andrea-cirillo/stm32_dali_led_driver/Docs/Schematics/Table_RvsQx.pdf

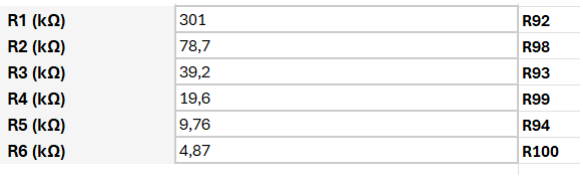
[picture p1: figure]
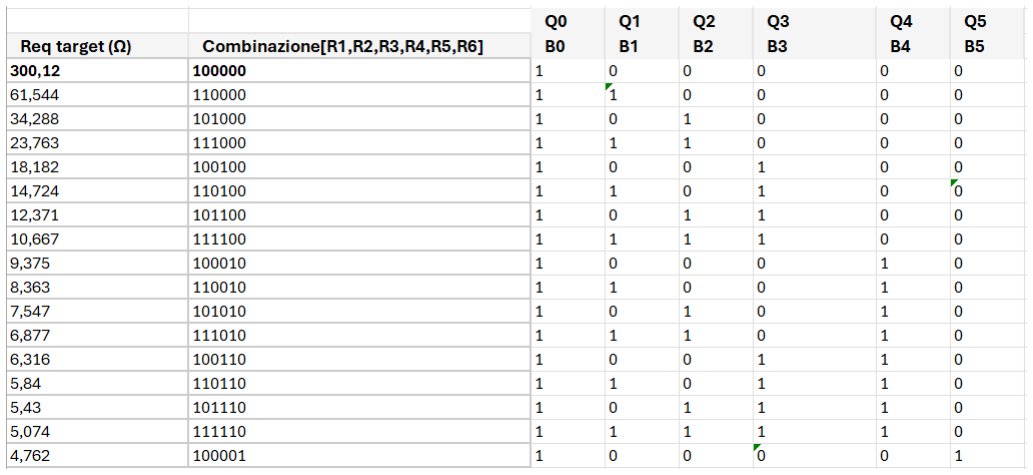
[picture p2: figure]
