andrea-cirillo/stm32_dali_led_driver/Docs/Schematics/stm32f030f4_dali_sch.pdf

## Current limitation selection

Current limitation selection | STCP SHCP CurrentLimit_DS | CS_out

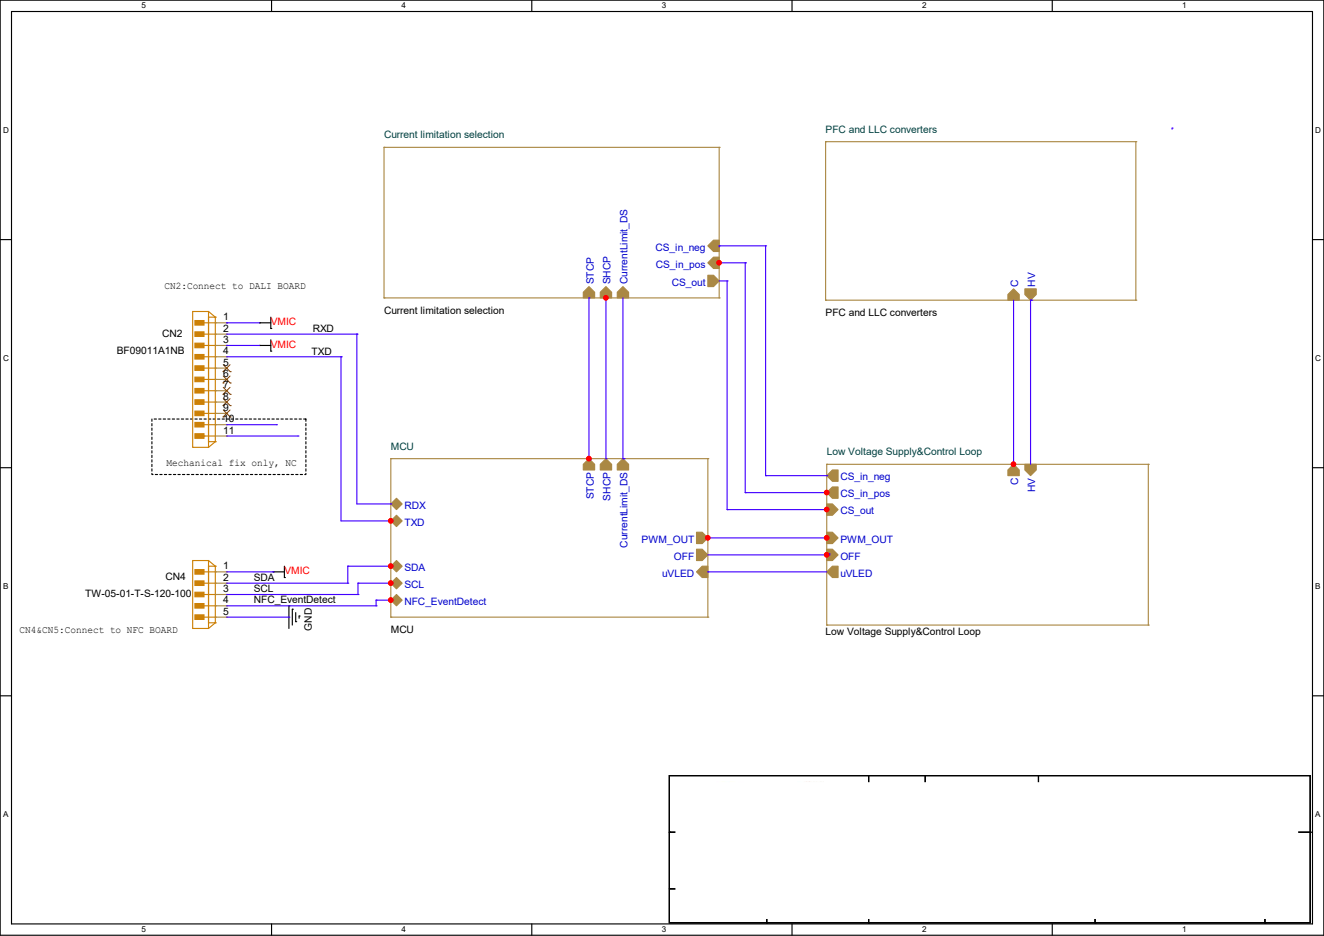
[picture p3: page 1]
VMIC GND; VMIC; CS_in_pos; CS_in_neg; PFC and LLC converters; CHV; MCU; STCP; SDA; SHCP CurrentLimit_DS RDX; PWM_OUT; NFC_EventDetect; SCL; OFF; uVLED; TXD; CS_out; RXD

PFC and LLC converters

CN2:Connect to DALI BOARD

Low Voltage Supply&Control Loop

Mechanical fix only, NC

CN4&CN5:Connect to NFC BOARD

Connect to DALI BOARD | Connect to Current limitation selection Connect to NFC BOARD | VDDA RST SWCLK SWDIO VDD GND

## Connect to Low Voltage Supply&Control Loop

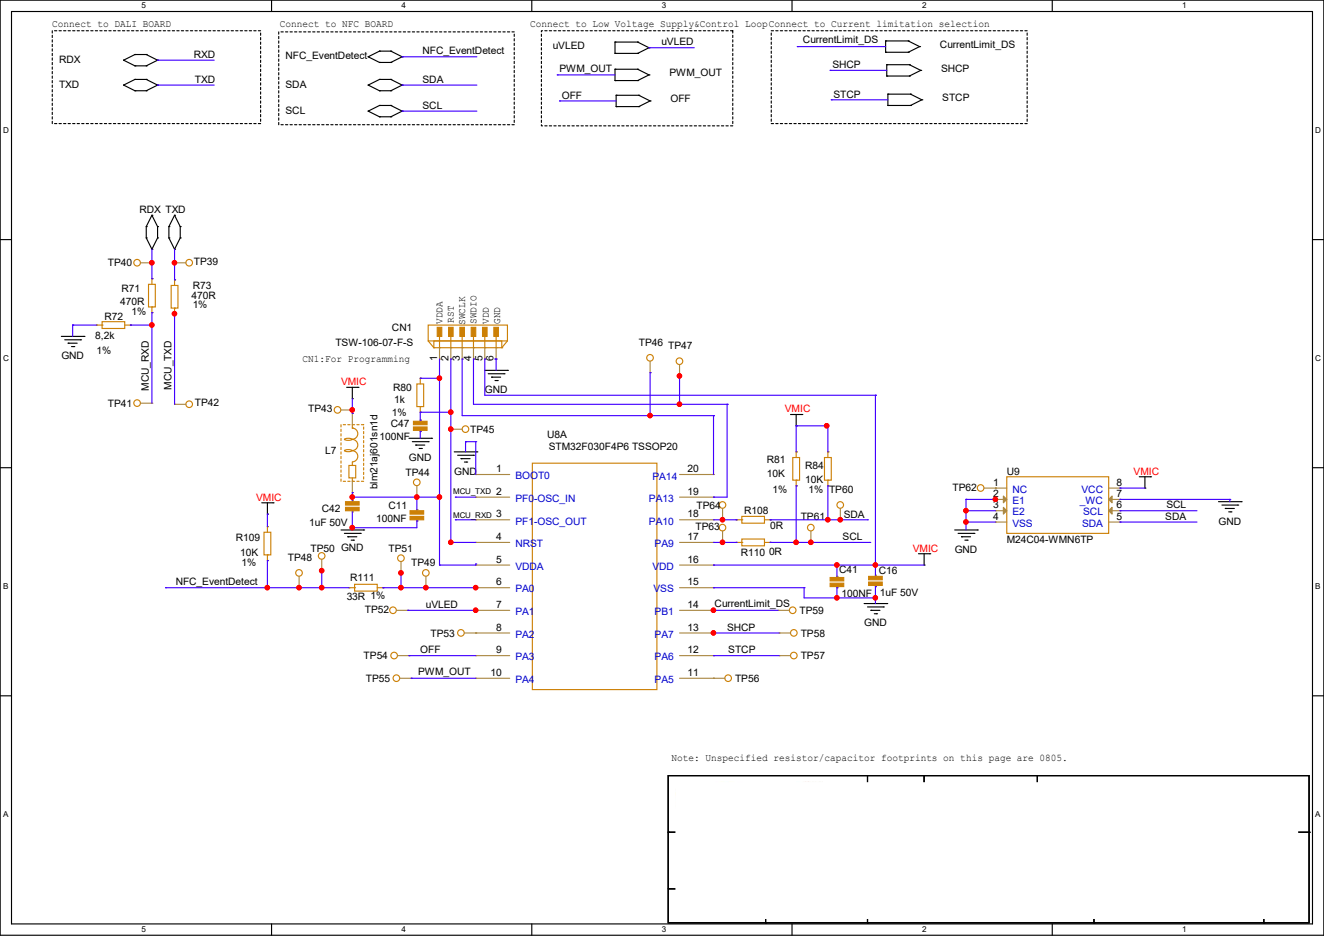
[picture p4: page 2]

Note: Unspecified resistor/capacitor footprints on this page are 0805.

L

N

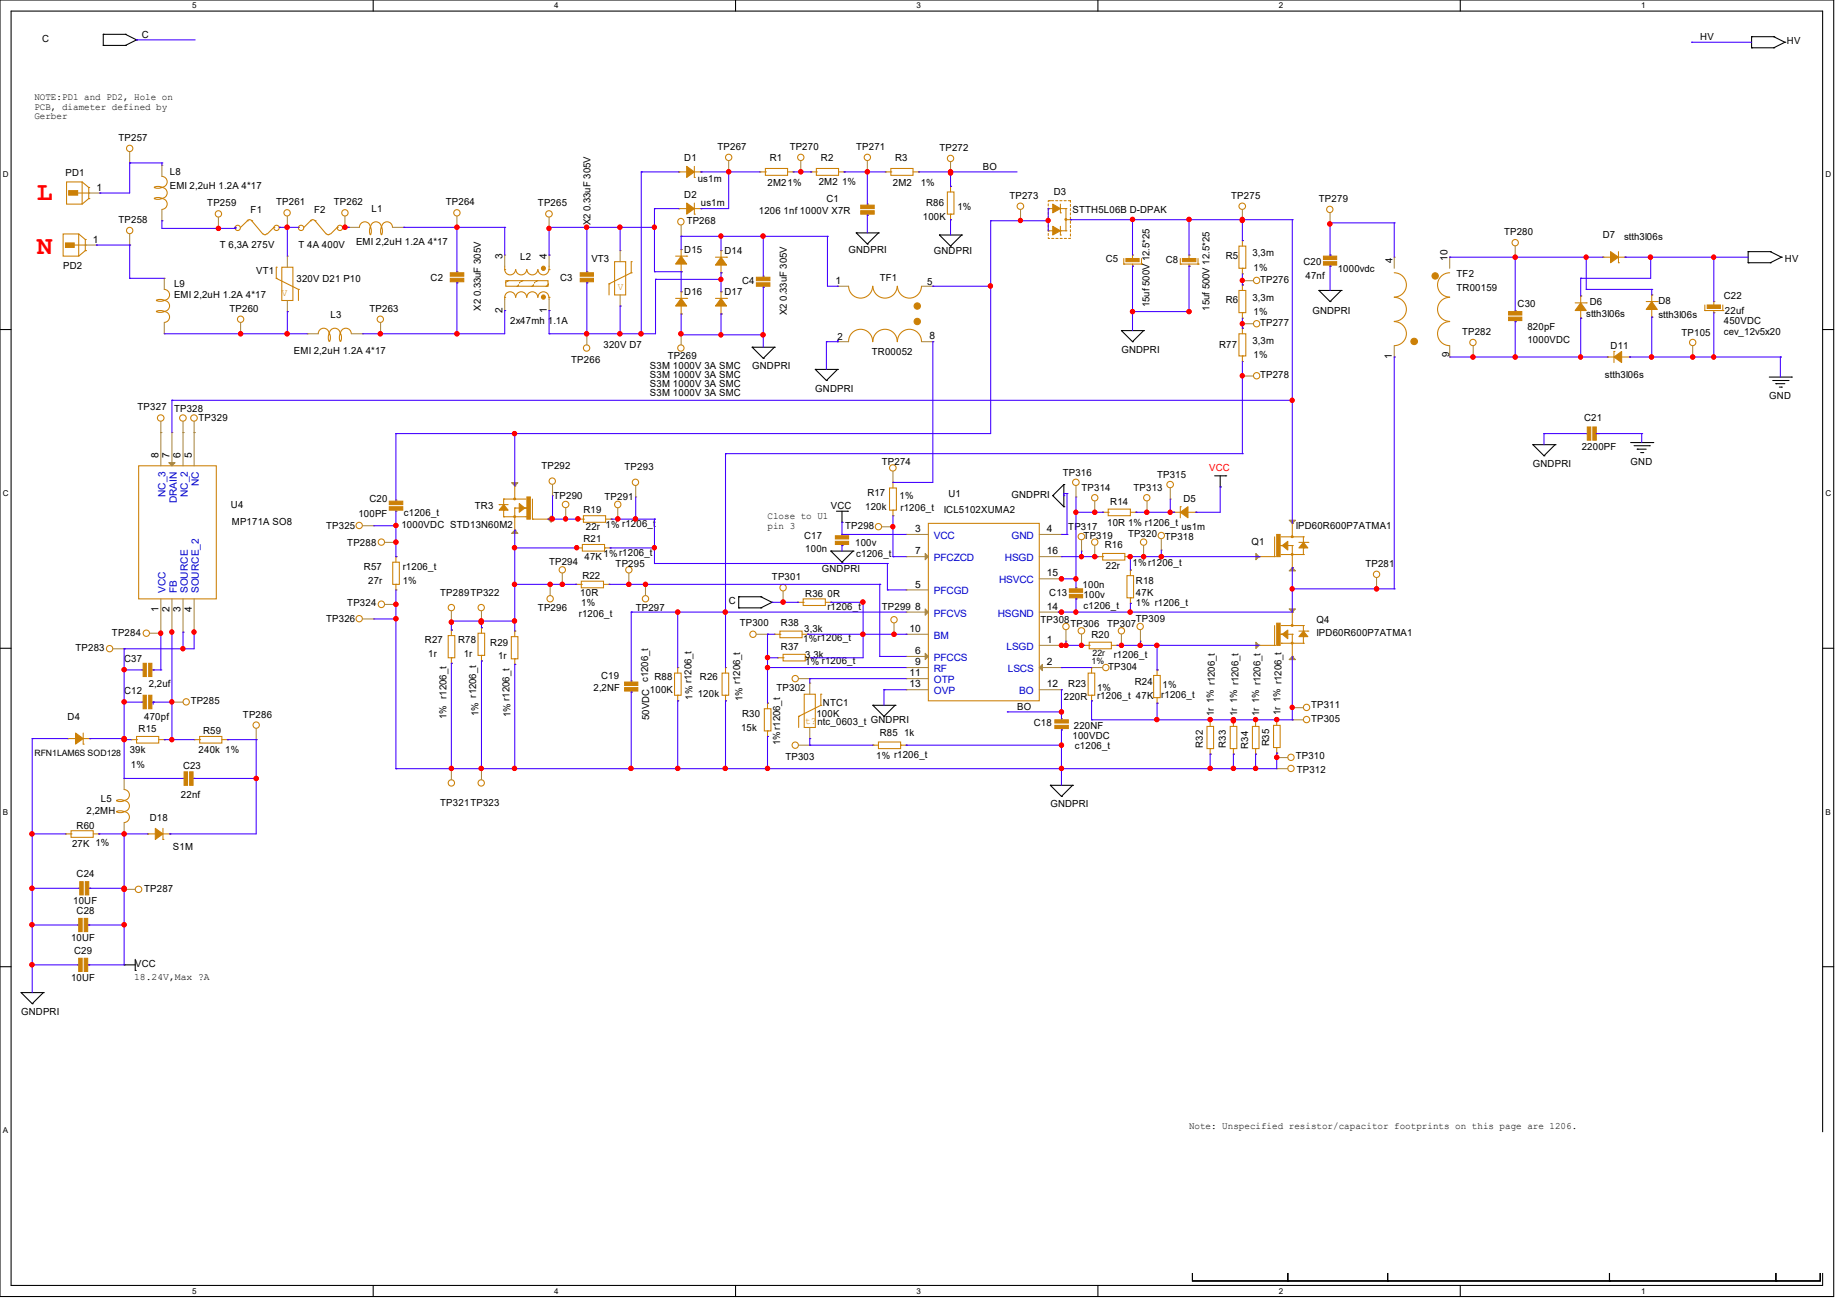
[picture p5: page 3]

NOTE:PD1 and PD2, Hole on
PCB, diameter defined by

Note: Unspecified resistor/capacitor footprints on this page are 1206.

# 1uF TP⁶⁶

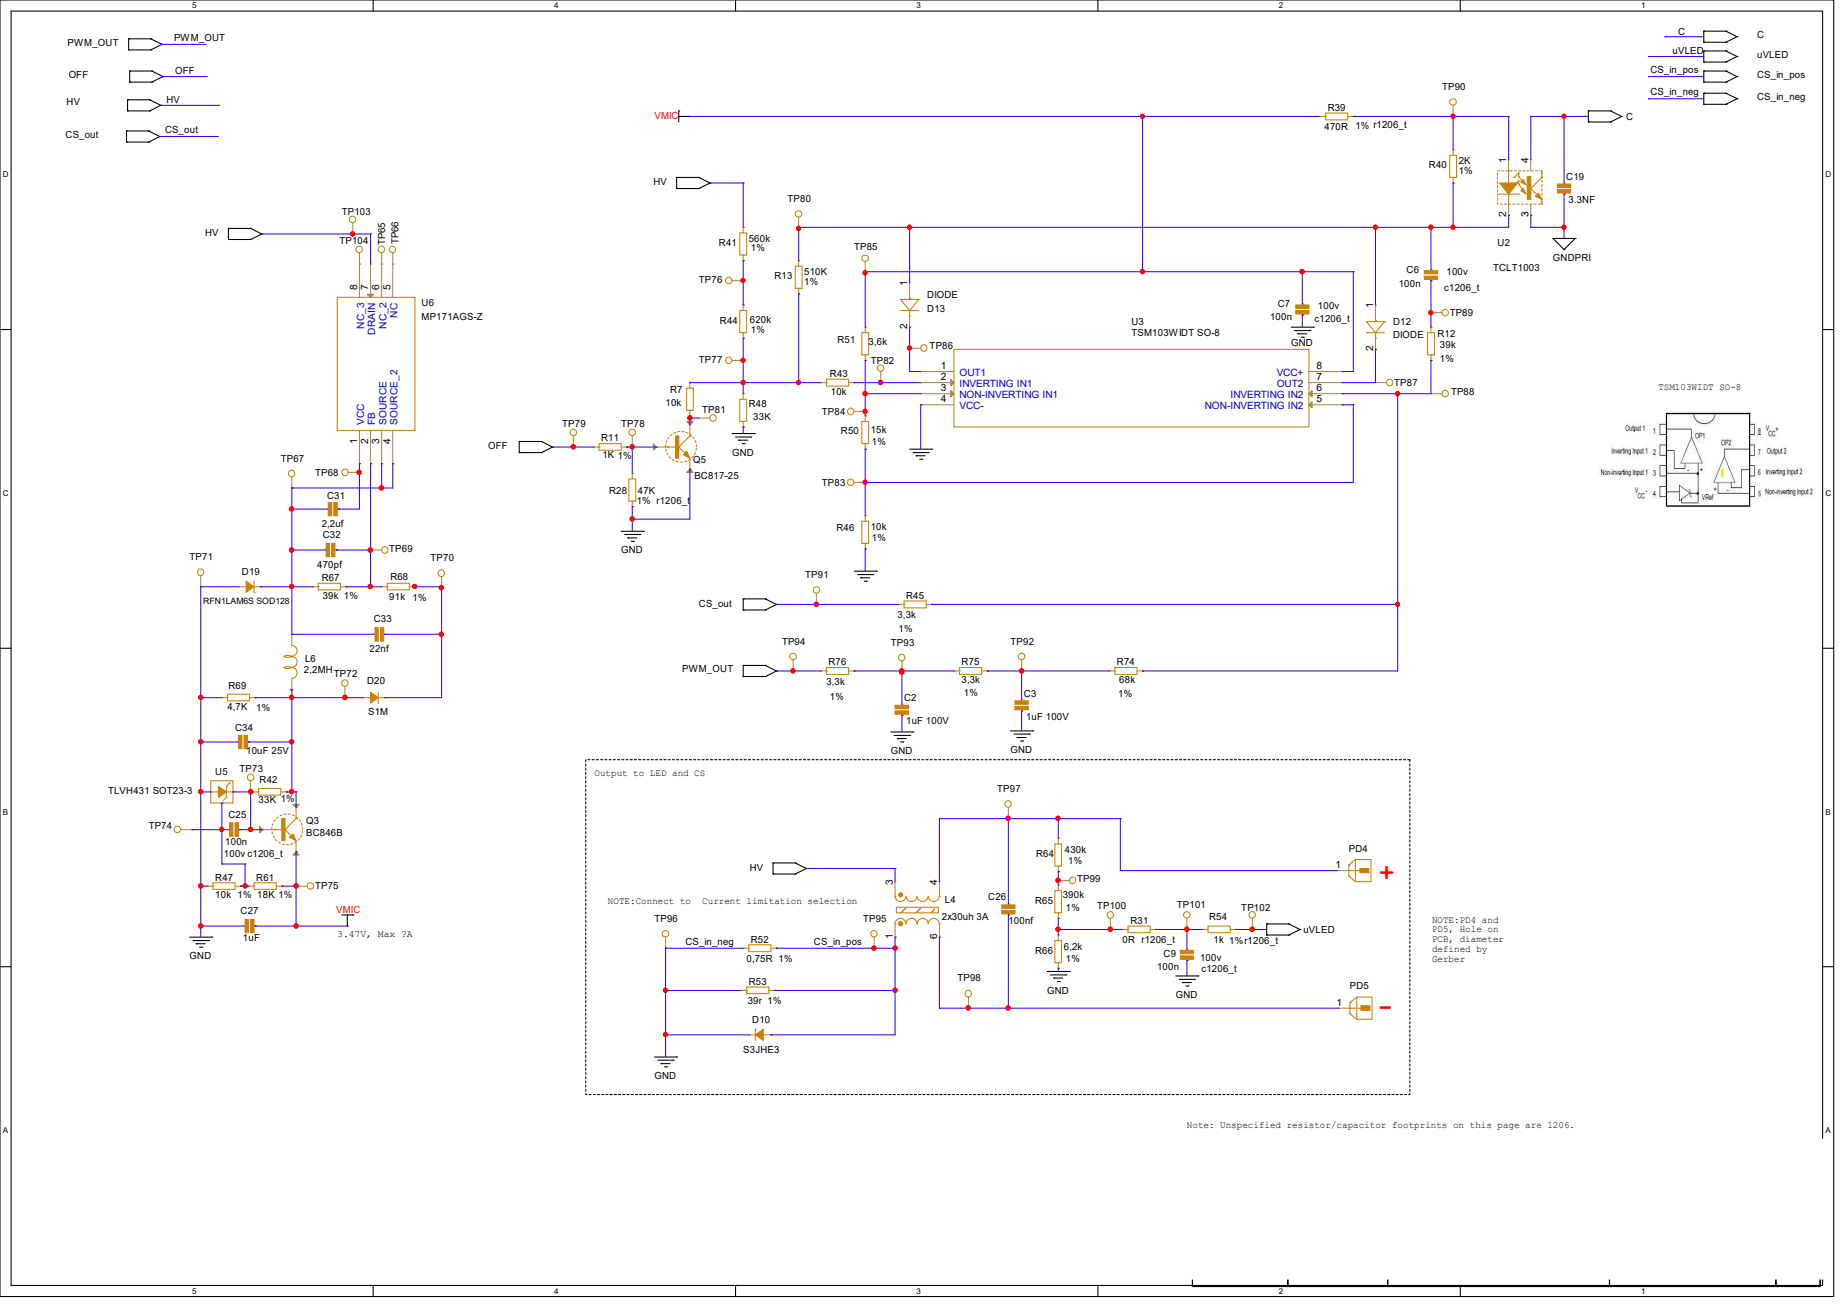
[picture p6: page 4]

NOTE:Connect to Current limitation selection

GND GND

- Note: Unspecified resistor/capacitor footprints on this page are 1206.

## Close to U7 pin 6 and pin 2

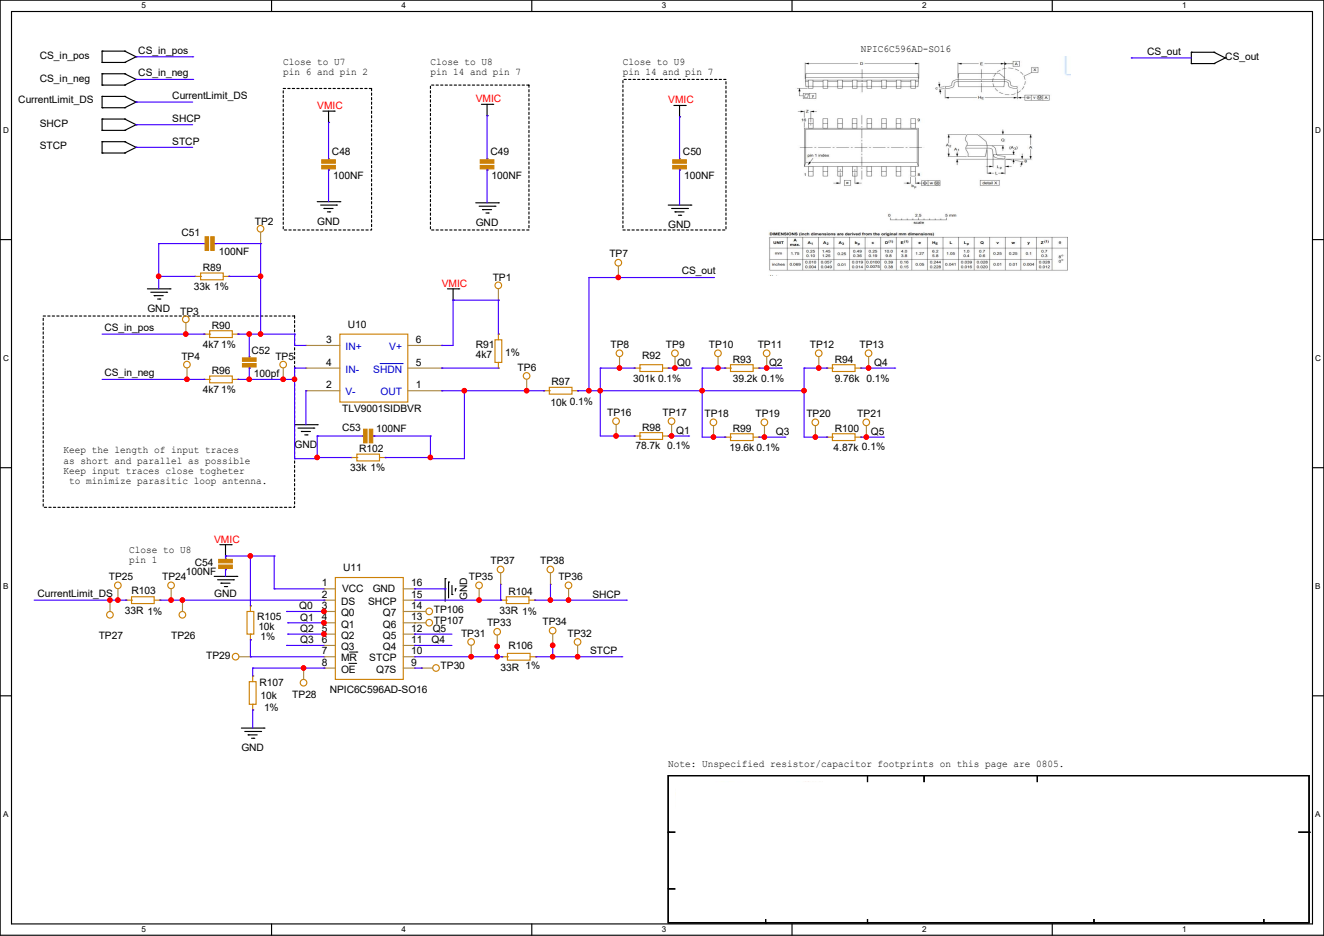
[picture p7: page 5]

Keep the length of input traces
as short and parallel as possible
Keep input traces close togheter
to minimize parasitic loop antenna.

VMIC
1 VCC 2 DS 3 Q0 4 Q1 5 Q2 6 Q3 7 MR 8 OE

Note: Unspecified resistor/capacitor footprints on this page are 0805.
