andrea-cirillo/stm32_dali_led_driver/(commit log)

2026-11-03 Added a Table with all the possible combinations of the selectable resistances
2026-11-03 Preliminary DALI-2 LED driver implementation (register level, no HAL)
    - Replace STM32Cube HAL with CMSIS register-level drivers so that the full
    stack fits in the 16 KB STM32F030F4 (13.2 KB with -Os, 15.2 KB with -Og).
    - DALI physical layer (IEC 62386-101): Manchester RX on PF1/EXTI1 with
    TIM3 time stamps, TX on PF0 driven by TIM3 CC2, build-time polarity.
    - Control gear (IEC 62386-102 ed.2) and LED device type 6 (IEC 62386-207
    ed.2): addressing, send-twice, fades (fade time/rate, extended, fast
    fade), scenes, groups, queries, system failure, identify, reset.
    - Memory banks 0, 1 (251), 202 (252) and 205/206 (253) with lock/latch.
    - uVLED monitoring: short/open/over/under voltage, OFF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
    [adc_drv.c, adc_drv.h, app_config.h, bsp.c, bsp.h, crc16.c, crc16.h, dali_gear.c]
2026-11-04 Add verbose Doxygen documentation to every function
    - Public APIs fully described in the headers: purpose, details, inputs
    (@param[in/out]), outputs (@return / return value), preconditions and
    execution context (main loop, SysTick, interrupt).
    - Every static function in the sources documented with a full block; the
    public definitions in the sources reference their header.
    - Former one-line comments (including the MISRA deviation notes) merged
    into the new blocks.
    - Doxyfile added: doxygen runs with no function / parameter warnings.
    No functional change: identical binary size, host tests unchanged.
    Claude-Session: https://claud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
2026-11-07 Fix OFF signal polarity: HIGH enables the power stage
    The OFF pin (PA3) drives Q5, which ENABLES the power stage when OFF is
    HIGH and disables it when OFF is LOW. The firmware used the opposite
    polarity.
    - New CFG_OFF_ENABLE_HIGH in app_config.h (default 1 = current hardware).
    - bsp.c: single off_pin_write() helper applies the polarity; early init
    drives OFF LOW (disabled), BSP_PowerStageEnable()/IsEnabled() follow it.
    - Docs and README updated. With R28 keeping Q5 off while PA3 floats at
    reset, the converter is disabled by default: the "shift register at
    power-up" open point is no longer a hazard.
    Claude-Session: https://claude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
    [app_config.h, bsp.c, bsp.h, light_ctrl.h]
